cctweaker/ESPsensor/Hardware/ESPsensor v1.2 top small.jpg

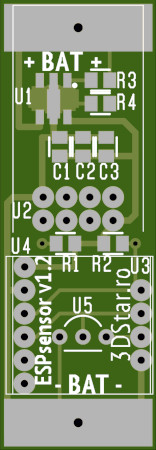
Hardware/ESPsensor v1.2 top small.jpg
