cctweaker/ESPsensor/Hardware/ESP-01 mod 2.jpg

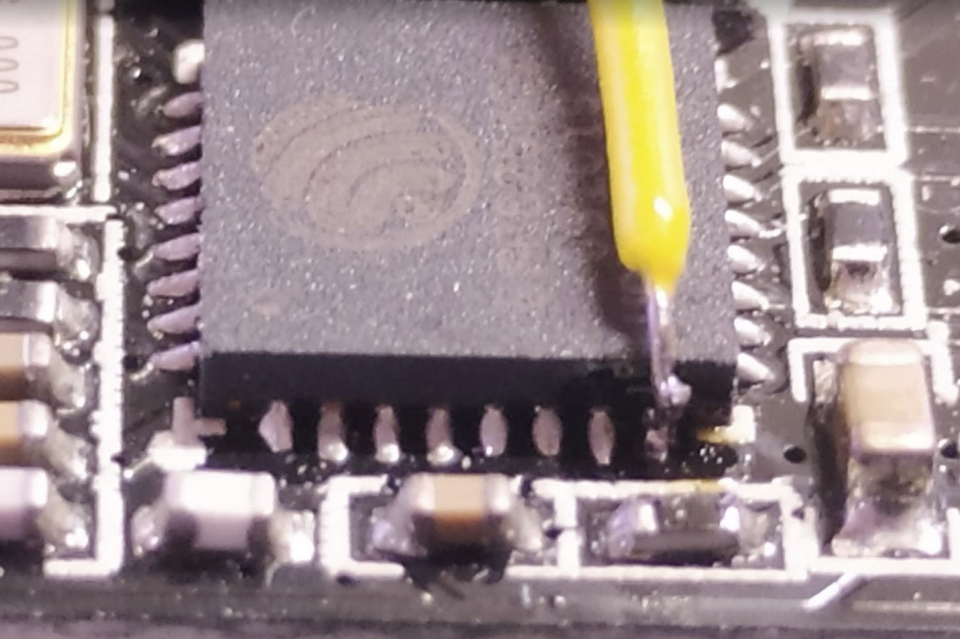
Hardware/ESP-01 mod 2.jpg
