cctweaker/ESPsensor/Hardware/ESP-01 mod 1.jpg

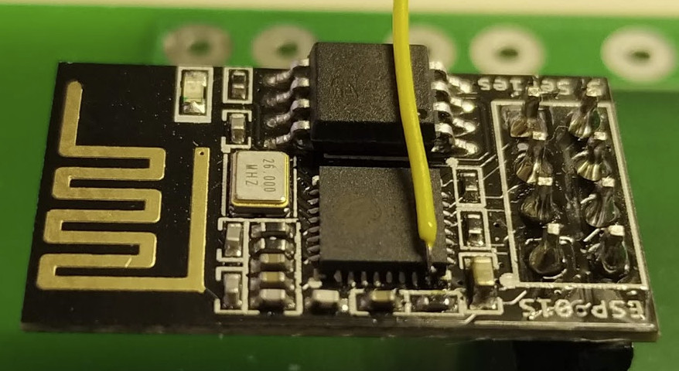
Hardware/ESP-01 mod 1.jpg
