cctweaker/ESPsensor/Hardware/ESP-01 mod 3.jpg

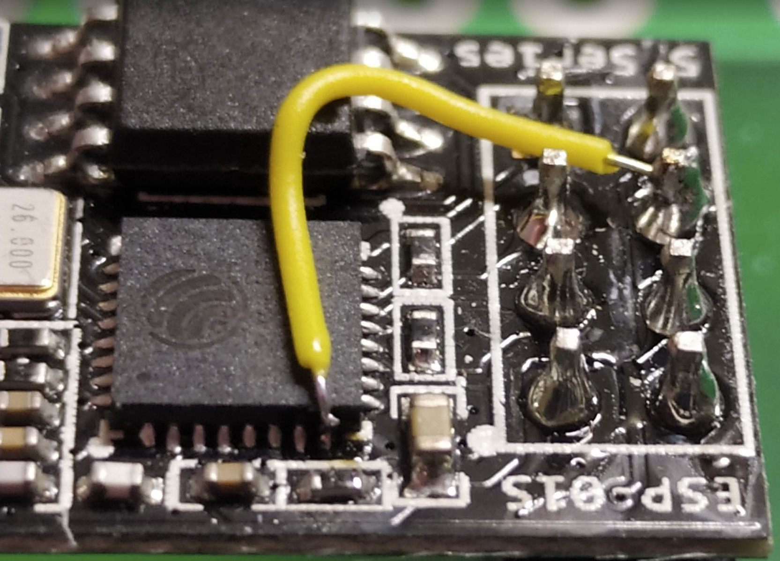
Hardware/ESP-01 mod 3.jpg
