cctweaker/ESPsensor/Hardware/ESP-01 mod 4.jpg

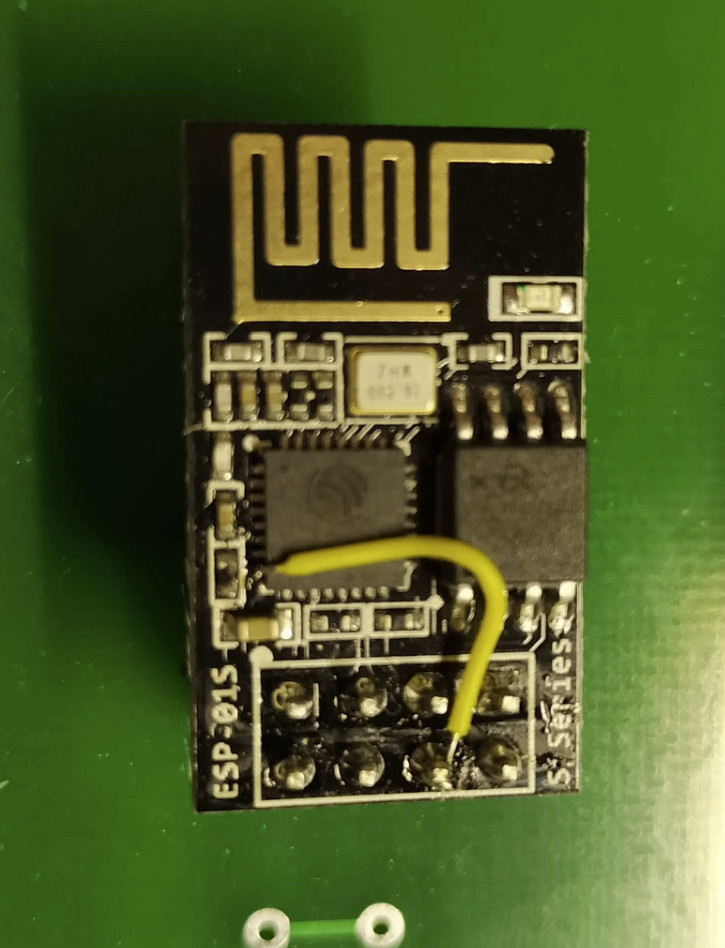
Hardware/ESP-01 mod 4.jpg
