cctweaker/ESPsensor/Hardware/ESPsensor v1.2 bottom small.jpg

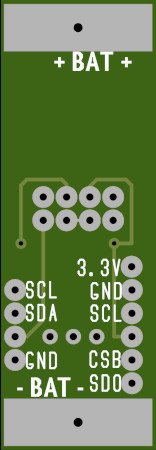
Hardware/ESPsensor v1.2 bottom small.jpg
