cctweaker/ESPsensor/Hardware/Schematic_ESPsensor_1.2.png

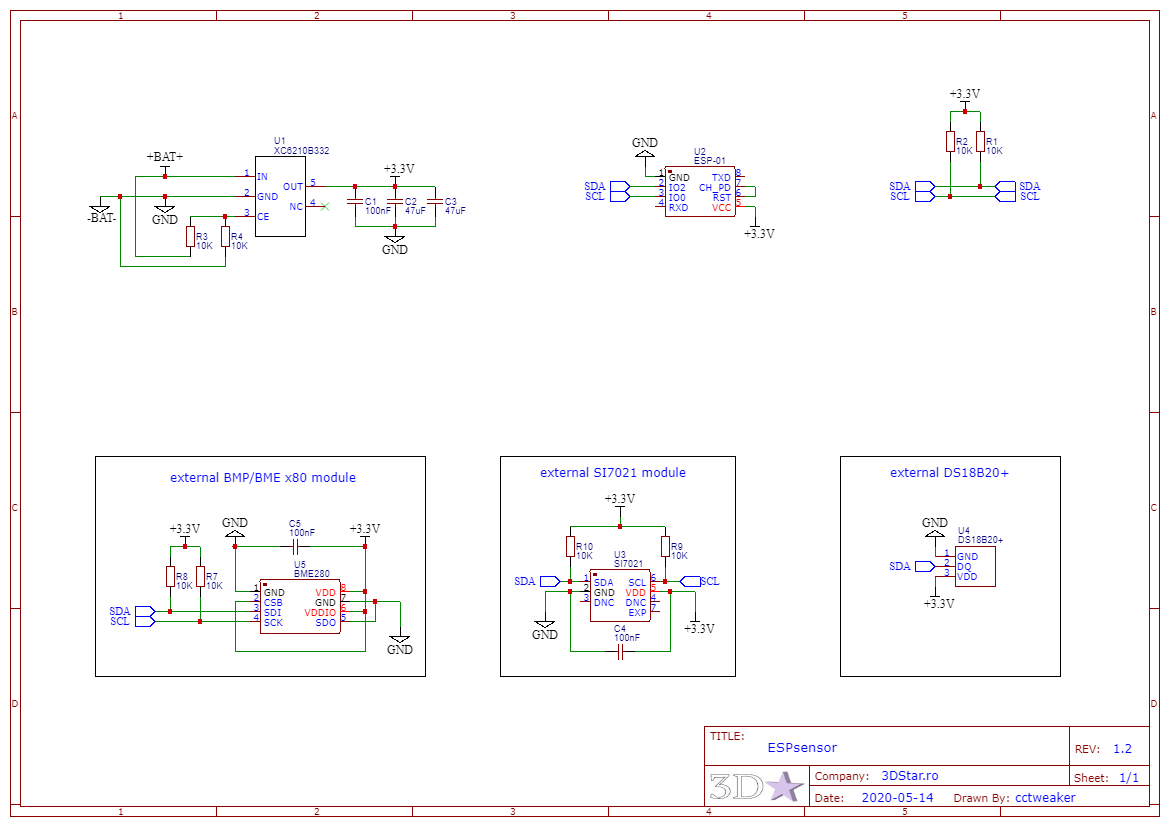
Hardware/Schematic_ESPsensor_1.2.png
