cctweaker/ESPsensor/Hardware/Schematic_ESPsensor_1.2.pdf

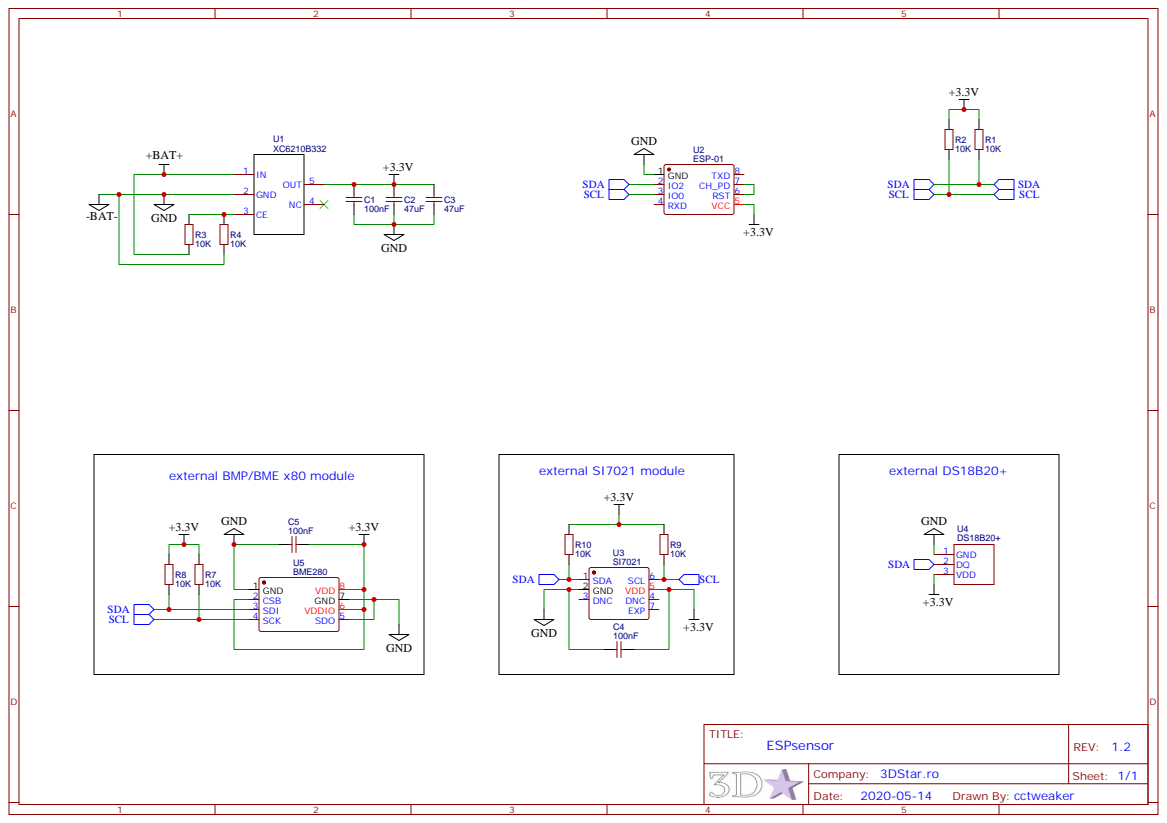
[picture p8: page 1]

external BMP/BME x80 module
