cctweaker/ESPsensor/(threads)

Thread 1 (2022-04-23):

Батарея

Knopaleo, 2022-04-23:
Здраствуйте. Какую батарею используете в проекте?

cctweaker, 2022-04-26:
Hi, Li-ion 18650 type.
2500mAh will last for about 13 months on ESP-Now with 1 minute deep sleep between readings using the SI7021 sensor.
